Jack-liu1998/temperature_52/document/hardware.jpg

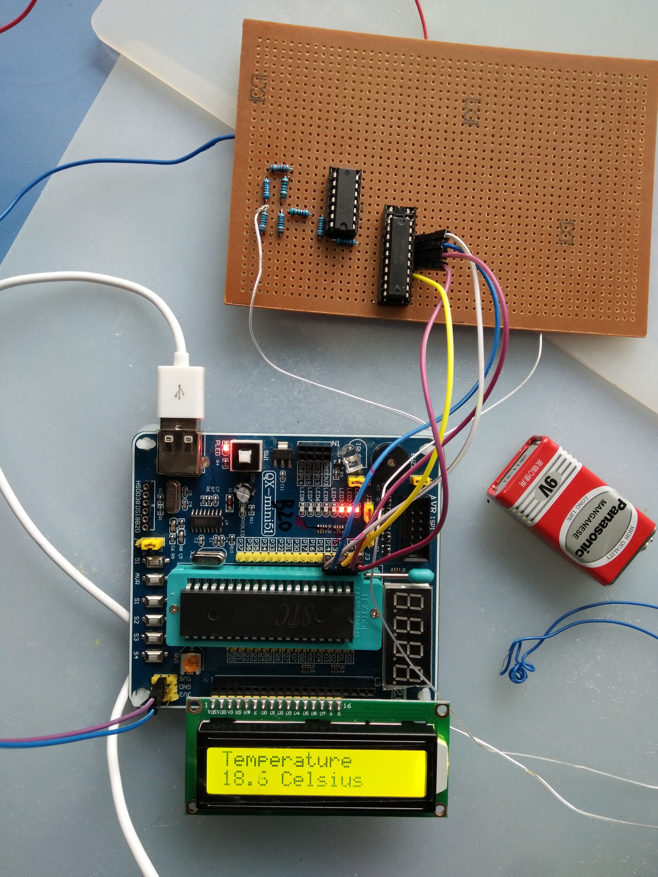
document/hardware.jpg
