Jack-liu1998/temperature_52/document/readme.txt

a thermometer based on STC89c52 MCU using RTD-PT100 thermistor
designed by Liu Sikun and Wang Xinyu in 2018/1
hardware list:
RTD-PT100 thermistor
LM324 OP
TLC2543 10bit AD
LM016L LCD
STC89c52  MCU 12MHZ crystals
