Jack-liu1998/temperature_52/document/stimulate/readme.txt

proteus中LCD1602与实际使用的硬件LCD1602A程序上并不兼容，因此仿真程序的相应部分有所调整。
