Jack-liu1998/temperature_52/(list of files, cad)

Other CAD files:
project/main.obj
project/warning.obj
project/ad-read.obj
project/LCD1602.obj
