Jack-liu1998/temperature_52/(list of files, drawings)

Other design files:
document/stimulate/temperature_proteus7.DSN
