Jack-liu1998/temperature_52/(commit log)

2018-01-19 add a picture
    [LCD1602.obj, ad-read.obj, main.obj, warning.obj, 仿真拟合参数.xlsx, 仿真电路_运放输出V、T对应表.xlsx]
2018-01-19 the end
    congratulation！！！
